bash-y/mesh-barista/wiki/pages/_Sidebar.md

**[[Home]]**

**Understand**
- [[System Architecture]]
- [[Safety Logic]]

**Build**
- [[Getting Started]]
- [[Hardware and Wiring]]
- [[Calibration]]
- [[Configuration Reference]]

**Use**
- [[Dashboard and Orders]]

**Develop**
- [[Working on the Hardware]]
- [[Development Workflow]]
  - [Story points guide](Development-Workflow#story-points-guide)
- [[Sprint Status]]
- [[Roadmap]]
- [[Handoff]]
