bash-y/mesh-barista/wiki/pages/Home.md

# Mesh Barista

A three-node ESP32 system that pours measured amounts of "coffee", "milk" and "cream" (dyed water) over
an ESP-NOW mesh, with no router, cloud service or API. It is a model of a smart water distribution
system: three reservoirs are the source tanks and the cup is the destination tank. Each node that owns an
actuator makes its own safety decisions, so losing any one node never leaves a pump running.

ENGR 4399 · Cyber-Physical & IoT Systems · Project 2. Team: Sebastian Cadena, Daniel Critchlow Jr.

## Start here

| If you want to… | Read |
| --- | --- |
| Understand how it works | [[System Architecture]] · [[Safety Logic]] |
| Build, wire and flash it | [[Getting Started]] · [[Hardware and Wiring]] · [[Calibration]] |
| Run the demo or order a drink | [[Dashboard and Orders]] |
| Look up a pin, threshold or timing | [[Configuration Reference]] |
| Work on the hardware without breaking it | [[Working on the Hardware]] |
| See what is being worked on | [[Sprint Status]] · [[Roadmap]] · [[Development Workflow]] |
| Pick up the project as the next agent | [[Handoff]] |

## Milestones

<!-- generate: milestones -->

## Documents

- [Presentation (PDF)](https://github.com/bash-y/mesh-barista/blob/main/docs/Mesh-Barista-Presentation.pdf)
- [Wiring guide (PDF)](https://github.com/bash-y/mesh-barista/blob/main/Mesh-Barista-Wiring-Guide.pdf)
- [Source code](https://github.com/bash-y/mesh-barista)
