bash-y/mesh-barista/wiki/pages/Sprint-Status.md

# Sprint Status

Read from the GitHub issues, using the UIW-PMD conventions in [[Development Workflow]]. Rebuilt whenever
an issue or milestone changes, and every morning. For the board view, burndown and velocity, use the
[project board](https://github.com/users/JuniorAndChill/projects/3) or the UIW-PMD dashboard.

## Milestones

<!-- generate: milestones -->

## Stories and tasks

<!-- generate: sprint -->

## Open bugs and issues

<!-- generate: open-bugs -->
