bash-y/mesh-barista/docs/Mesh-Barista-Presentation.pdf

E N G R | 4 3 9 9 | · | C Y B E R - P H Y S I C A L | & | I O T | S Y S T E M S | · | P R O J E C T | 2

# Mesh Barista

## A distributed, resilient pump control system that pours a

measured cup of coffee, milk and cream.

T E A M
Sebastian Cadena · Daniel Critchlow Jr | November 12, 2026

# Problem and motivation

## A pump that keeps running after it loses contact with its tank wastes water and

destroys itself.

Project 1 put every decision in one ESP32 and a cloud API. Real water systems are spread out, and nodes fail without warning.

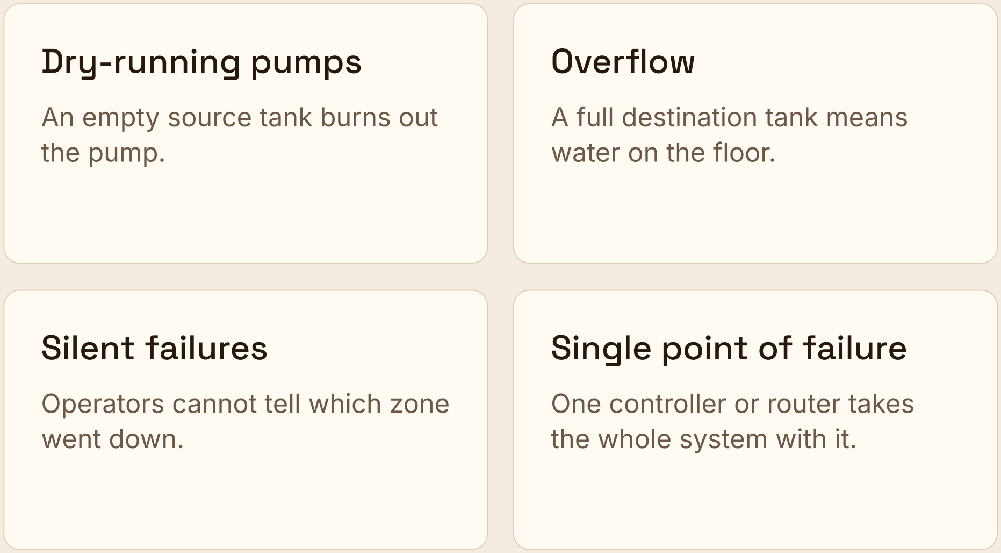
[picture p2: figure]
Dry-running pumps; An empty source tank burns out the pump.; Overflow; A full destination tank means water on the floor.; Silent failures; Operators cannot tell which zone went down.; Single point of failure; One controller or router takes the whole system with it.

Our model of it: three reservoirs are the source tanks, the cup is the destination tank, and dyed water stands in for the drinks.

MESH BARISTA · ENGR 4399 PROJECT 2 · 2 / 7

# System architecture

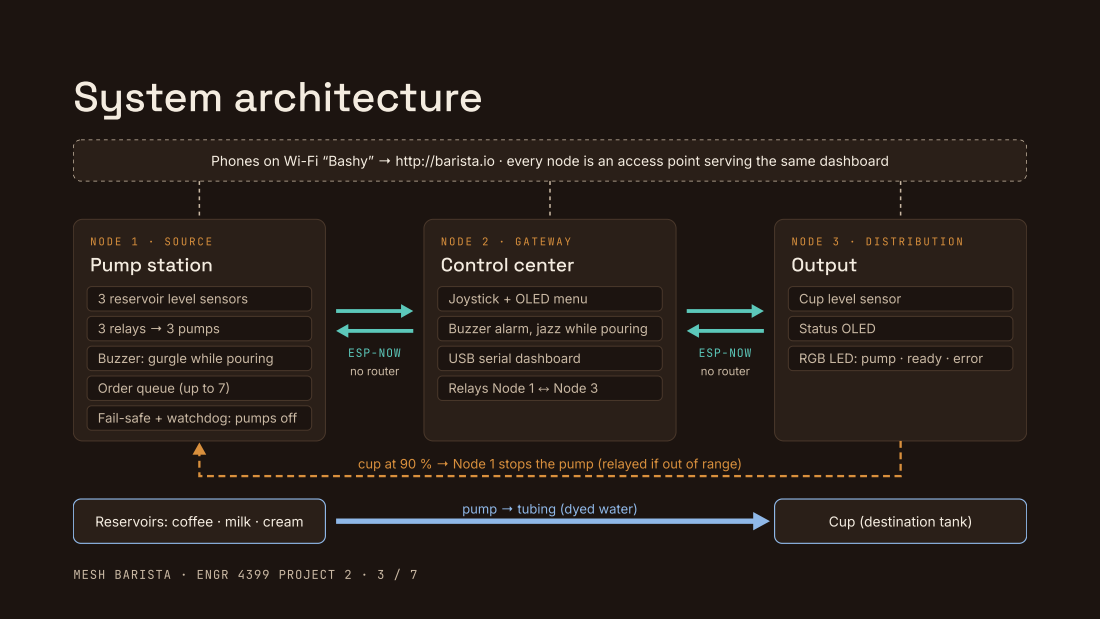
[picture p3: page 3]
Pump station; 3 relays → 3 pumps; Control center; Output; Status OLED; ESP-NOW no router; Reservoirs: coffee · milk · cream; Cup (destination tank)

Phones on Wi-Fi “Bashy” → http://barista.io · every node is an access point serving the same dashboard

3 reservoir level sensors

Joystick + OLED menu

Cup level sensor

Buzzer alarm, jazz while pouring

Buzzer: gurgle while pouring

USB serial dashboard

RGB LED: pump · ready · error

Order queue (up to 7)

Relays Node 1 ↔ Node 3

Fail-safe + watchdog: pumps off

cup at 90 % → Node 1 stops the pump (relayed if out of range)

pump → tubing (dyed water)

# Technical implementation

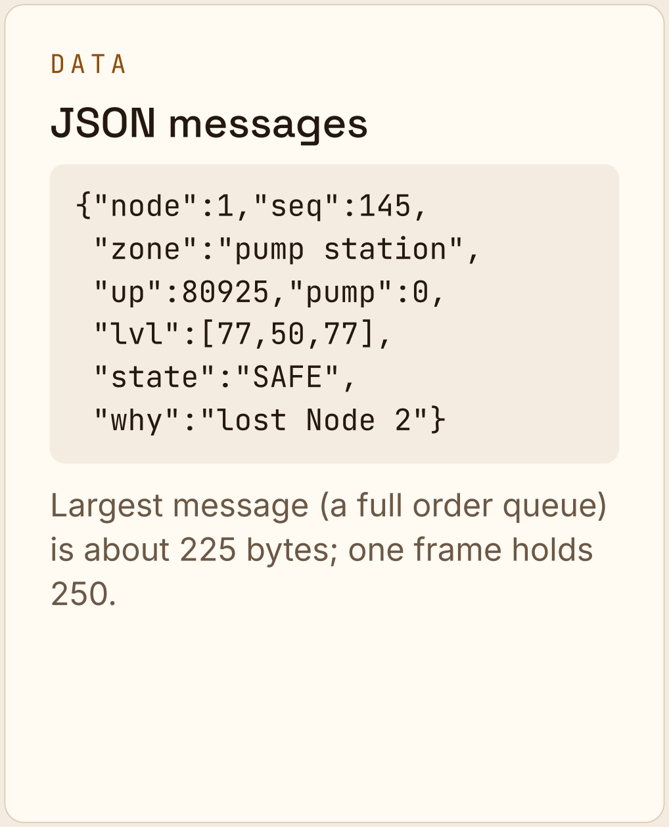
[picture p4: figure]
D A T A JSON messages; {"node":1,"seq":145,; "zone":"pump station",; "up":80925,"pump":0,; "lvl":[77,50,77],; "state":"SAFE",; "why":"lost Node 2"}; Largest message (a full order queue) is about 225 bytes; one frame holds 250.

W I R E L E S S
ESP-NOW with our own relay

Broadcast frames: no router, no pairing.
Sequence numbers drop repeats.
A node rebroadcasts what it hears once, so a node out of range is still reached.
Heartbeat every second; lost after 3 s.

I N T E R F A C E
Dashboard on every node

Each ESP32 serves the page and a JSON status feed over HTTP. Shows nodes alive or lost, levels, pump state, event log and mesh paths.
Test buttons run pumps, buzzers and the LED.
Order queue: anyone in the room joins the open “Bashy” Wi-Fi and orders a drink from their phone; the operator pours orders in turn with the joystick or the dashboard.

# Sustainability logic

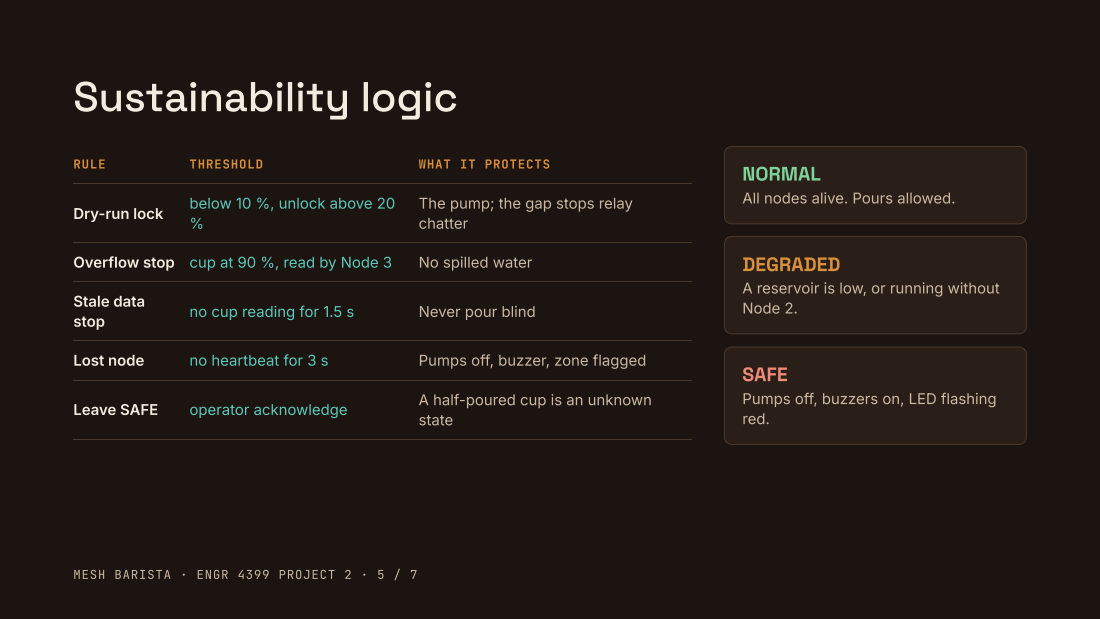
[picture p5: page 5]
RULE; THRESHOLD; WHAT IT PROTECTS; Overflow stop cup at 90 %, read by Node 3; No spilled water; Stale data stop; no cup reading for 1.5 s; Never pour blind; Lost node; no heartbeat for 3 s; Pumps off, buzzer, zone flagged; Leave SAFE; operator acknowledge

NORMAL
All nodes alive. Pours allowed.

below 10 %, unlock above 20

The pump; the gap stops relay
chatter

Dry-run lock

DEGRADED
A reservoir is low, or running without
Node 2.

SAFE
Pumps off, buzzers on, LED flashing
red.

A half-poured cup is an unknown
state

# Results and demonstration

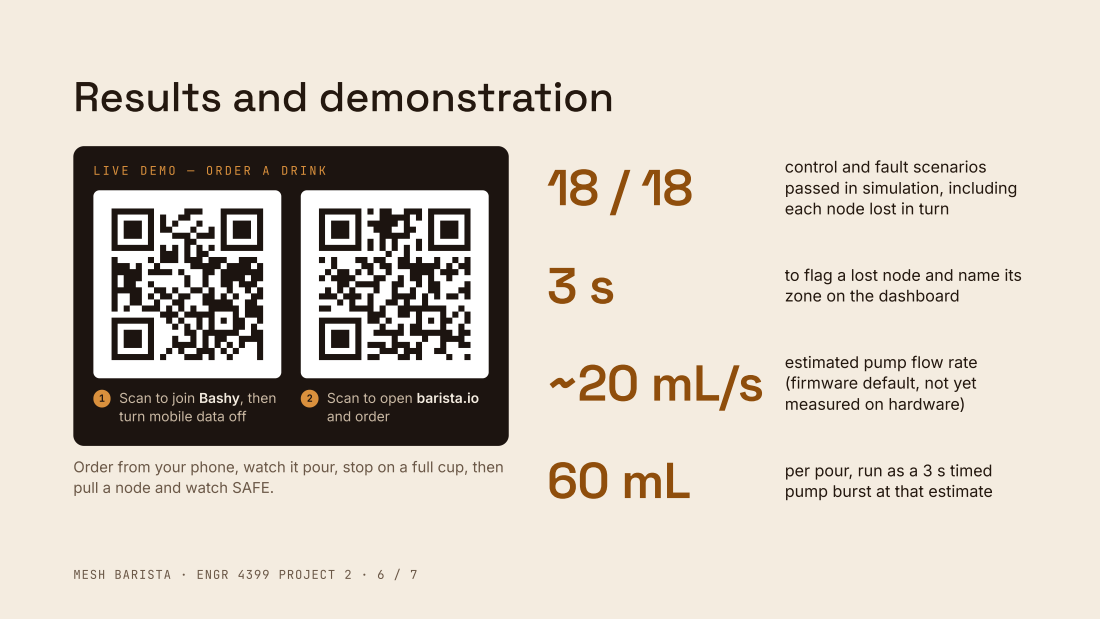
[picture p6: page 6]
Scan to open barista.io; and order

control and fault scenarios
passed in simulation, including
each node lost in turn

to flag a lost node and name its
zone on the dashboard

estimated pump flow rate
(firmware default, not yet
measured on hardware)

Scan to join Bashy, then
turn mobile data off

Order from your phone, watch it pour, stop on a full cup, then
pull a node and watch SAFE.

per pour, run as a 3 s timed
pump burst at that estimate

# Lessons learned and improvements

W H A T | W A S | H A R D
Engineering challenges

A full mesh library was more than three nodes needed; ESP-NOW with a small relay was simpler to reason about.
A clicking relay does not prove the pump has power: the pump circuit needs its own test.
A joystick does not rest at mid-scale, so it is calibrated at boot.
Raw pin readings found GPIO 34 tied to ground, even with a new joystick; the X axis moved to GPIO 32.
Electrical noise from the cream pump froze Node 1 with its relay closed; a watchdog now resets it into SAFE with every pump off.
Passive buzzers are silent on a plain on/off signal; the alarm needed a real tone. The cup sensor’s 2″ strips cover only part of a 4.5″ cup and are not linear, so every sensor uses a multi-point calibration.
W H A T | C O M E S | N E X T
Future enhancements

Load cell under the cup to pour by weight. Servo pinch valve so SAFE also closes the outlet.
Flow check that catches a blocked tube or empty line.
Encrypted ESP-NOW and a login on the dashboard.
