bash-y/mesh-barista/wiki/pages/Dashboard-and-Orders.md

# Dashboard and Orders

<!-- include: README.md#Dashboard -->
