bash-y/mesh-barista/wiki/pages/Getting-Started.md

# Getting Started

<!-- include: README.md#Build -->

<!-- include: HANDOFF.md#How to work on the hardware -->

Next: [[Hardware and Wiring]], then [[Calibration]].
