bash-y/mesh-barista/wiki/pages/Hardware-and-Wiring.md

# Hardware and Wiring

<!-- include: WIRING.md -->

## Hardware facts worth keeping

<!-- include: HANDOFF.md#Hardware facts worth keeping -->
