bash-y/mesh-barista/(commit log)

2026-11-12 Mesh Barista: three ESP32 nodes on ESP-NOW with a web dashboard
    Claude-Session: https://claude.ai/code/session_01Gj7K4G4AUexXV24d5sPsda
2026-11-12 Add step-by-step wiring guide
    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
2026-11-12 Add illustrated wiring guide PDF
    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
2026-11-12 Wiring guide: white cover and page backgrounds
    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
2026-11-12 Move Node 2 joystick VRx from GPIO 34 to GPIO 32
    GPIO 34 read near 0 V with nothing attached on our board, so left/right
    never registered. GPIO 32 is also ADC1, so it still works with the radio on.
2026-11-12 Node 3: averaged, multi-point cup reading
    The cup is 4.5" tall but the sensor strips are only 2.0", so they are mounted
    with their top at the rim and cover 56-100 % of the cup. The strips are not
    linear, so the reading is interpolated between six calibration points (dry,
    2.5", 3.0", 3.5", 4.0", 4.5") instead of a straight dry-to-full scale, and
    each reading averages 32 samples. Node 3 prints the raw value on serial for
    calibration. CUP_RAW still holds placeholders until the cup is calibrated.
2026-11-12 Node 1 watchdog, passive buzzer tones, pour music and gurgle
    - Node 1: a 3 s task watchdog resets the chip if loop() freezes, so a hang
    (seen when the cream pump starts) can never leave a pump running. The
    reset reason (watchdog, brownout, crash) is logged at boot.
    - The buzzers on Nodes 1 and 2 are passive, so the old digitalWrite alarm
    was silent. Alarm and test beeps are now a 2.7 kHz tone.
    - barista_music.h: non-blocking tune player. While a pump runs, Node 2
    plays an original swung jazz melody (Gm7 C7 Fmaj7 D7) and Node 1 makes a
    coffee machine gurgle (or a walking bass line, POUR_SOUND). Node 2 also
    plays a "drink ready" phrase after a pour and a chime at boot. The alarm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
    [barista_music.h, build_assets.py, node1_pump_station.ino, node2_control_center.ino]
2026-11-12 Wiring guide: Node 2 joystick VRx on GPIO 32
    Matches the firmware change in 268179e. The build script now takes the
    Chrome path from $CHROME so it also builds on macOS.
2026-11-12 Rebuild the presentation from source, updated for the live demo
    The deck was only a PDF; docs/build_presentation.py now generates it (HTML
    printed by Chrome, same pattern as the wiring guide). Slide 3 adds the
    watchdog and pour sounds, slide 4 the order queue, slide 6 becomes a live
    demo with a QR code to join the Wi-Fi, and slide 7 adds today's lessons.
    The pour error and flow rate stats are still placeholders.
    [build_presentation.py]
2026-11-12 Order queue: anyone on the Wi-Fi orders a drink from their phone
    - Dashboard opens on a new Order tab: name, pick a drink, see your place in
    line, get told when it is ready. #op adds Pour next and Remove buttons.
    - Node 1 keeps the queue (max 7, fits one ESP-NOW frame) and pours a
    drink's ingredients one by one. Every safety rule still applies to each
    step; any stop cancels the rest of the order.
    - Orders carry a random key and "next" names the order id, so a message
    the mesh delivers twice cannot queue or pour twice.
    - Node 2: a click pours the next order, the OLED shows who is next, and
    the music plays through the whole drink. Node 3's OLED shows whose drink.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
2026-11-12 Sensor positions: cup strips 3 cm below the lip, reservoir sensors on the bottom
    - Node 3: the top of the strips (3 cm below the lip) is the cup's full line,
    so the strips cover 40-100 % and the 90 % stop can trigger. Calibration
    points at dry, 3.4, 4.6, 5.9, 7.2 and 8.4 cm.
    - Node 1: reservoir sensors stand on the bottom and watch the last 5 cm.
    Readings average 16 samples and use a five-point calibration (dry, 1.3,
    2.5, 3.8, 5.1 cm) instead of a straight dry-to-full scale.
    - Dashboard hint, WIRING.md and slide 7 updated. Calibration values are
    still placeholders.
2026-11-12 Estimated sensor calibration, reservoir 0 % at the pump's empty point
    - Reservoirs: a pump can't pull below about 1 cm, so that level is now 0 %
    and the top of the strip (5.1 cm) is 100 %; the 10 % dry-run lock trips
    before a pump sucks air. Only the 0 % column was measured.
    - Cup: measured dry (138) and at 4.25 cm (1054); the other points are
    estimated from the usual curve of these strip sensors.
    - TODO(calibration) notes in both sketches and the README: the values are
    mostly estimates, the sensors drift 50-100 counts, and the dry-run lock
    and 90 % cup stop are rough backstops until measured with a ruler.
    - Node 1 prints "levels raw=" on serial once a second for calibrating.
    Co-A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
    [node1_pump_station.ino, node3_output.ino]
2026-11-12 Add HANDOFF.md: open work, safe flashing, known traps
    Prioritized to-do list (demo prep, calibration, docs, known code
    weaknesses), how to flash without committing Wi-Fi credentials, and the
    serial-port and build traps hit so far. Linked from the README.
2026-11-12 Dashboard: hide operator controls from the audience
    Without #op the page shows only the Order and Live tabs and no Acknowledge
    button; Stop pump stays available to everyone. http://barista.io/#op shows
    the Test and System tabs, Acknowledge, and the queue's Pour next / Remove.
    This hides controls only: /cmd still accepts any command.
2026-11-12 Slide 6: show flow rate as an estimate instead of placeholders
    The pump flow rate is still the 20 mL/s firmware default and pour error
    was never measured, so slide 6 now labels the rate as an estimate and
    shows the 60 mL timed pour in place of the pour-error stat. Stats use a
    shared grid so wide numbers stay on one line.
    [build_presentation.py]
2026-11-12 Slides: system design diagram on slide 3, second QR code on slide 6
    Slide 3 is now a block diagram: phones reach the dashboard on every
    node over Wi-Fi, the three nodes with their hardware are linked by
    ESP-NOW, water flows from the reservoirs to the cup, and the cup level
    goes back to Node 1 to stop the pump.
    Joining by scanning a Wi-Fi QR code does not open the captive-portal
    page the way joining from Wi-Fi settings does, so slide 6 adds a second
    QR code that opens http://barista.io. README notes why.
2026-11-12 Agile workflow: issue templates, AGILE.md, presentation feedback
    Issue templates for User Story, Task, Issue, Bug and Sub-task follow the
    UIW-PMD conventions (type prefix and label, Parent: #N, Story points: N,
    Blocked by #N), plus a PR template with Closes #N. docs/AGILE.md covers
    the hierarchy, board columns, Definitions of Ready and Done, the sprint
    routine, branches, and connecting the UIW-PMD dashboard. HANDOFF.md gets
    Dr. Okan's feedback from the Nov 12 presentation as items 15-21.
2026-11-12 Wiki: generated from wiki/pages and published by a GitHub Action
    Pages are Markdown templates that include sections of README, WIRING,
    HANDOFF and docs/AGILE.md, so those files stay the only copy. Generated
    sections add a settings reference from the sketches and sprint status
    and milestone progress from the GitHub issues. The Wiki workflow
    publishes on pushes to main, issue and milestone changes, every morning
    and on demand; on pull requests it only checks that every include
    resolves.
